sshspb/grus2/images/logic-levels.jpg

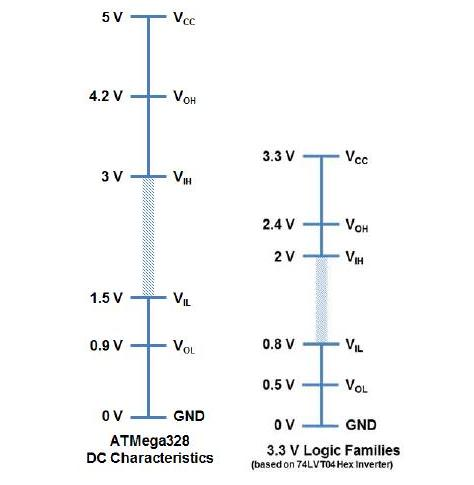
images/logic-levels.jpg
